w-corbello/Christmas_Light_Tester/board/Board_Connections.jpg

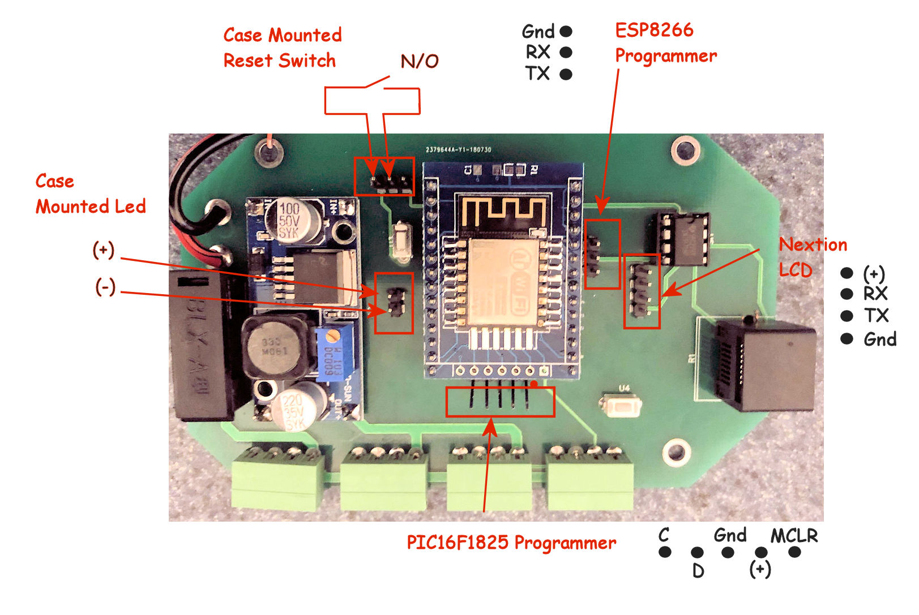
board/Board_Connections.jpg
