w-corbello/Christmas_Light_Tester/board/IMG_1061.JPG

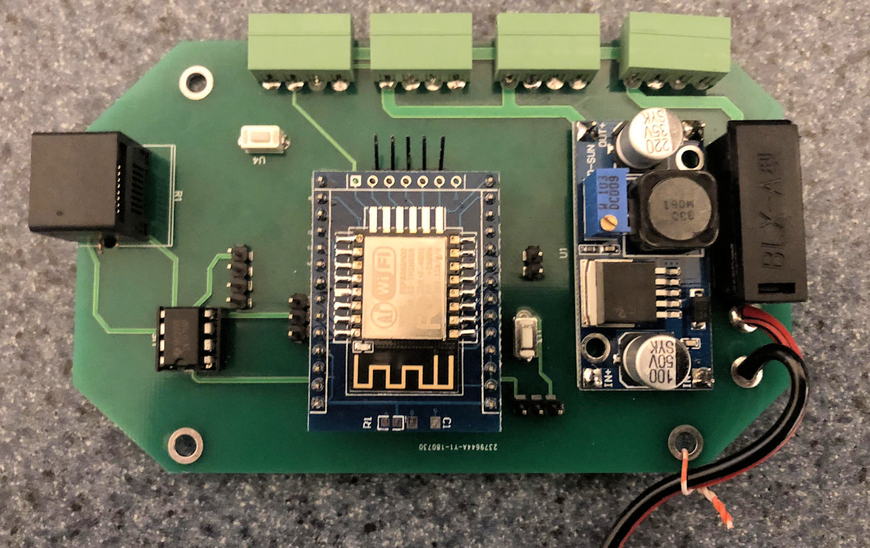
board/IMG_1061.JPG
