w-corbello/Christmas_Light_Tester/schematics/README.md

Files:

Board_Connections.jpg - shows where to make connection

Christmas Light Tester.pdf - manual

PC_Bottom_Board.pdf - PC board bottom

PC_Complete_Board.pdf -  PC board complete

PC_Top_Board.pdf - PC board top

Schematic_tester.pdf - electrical

Components.txt - components used
