w-corbello/Christmas_Light_Tester/board/README.md

Pictures of boards:

EasyEDA.com was used to draw the board, they also offer manufacturing of the boards. "EasyEDA_ Xmas_light_tester_v3.svg" can be imported from the EasyEDA.com website to view or modify the boards.
