w-corbello/Christmas_Light_Tester/files/README.md

Artnet_Sender.h  -  Transmits DMX over wifi usinf artnet or sacn.

Christmas_Tester_06122018_v3_7.ino - Main Aduino program.

EEPROM_Map.txt - used just to keep track of eeprom locations I'm using.

monitor.h - Used to monitor or view a sacn being transmitted.

nextion_1.h - Used to 'talk' to the Nextion LCD module over serial.

remote_1.h - Function file I wanted out of the main Arduino program.

renard.h - Used to transmit the Renard protocol.

ws2801.h - Used to test the 4 wire WS2801.
