w-corbello/Christmas_Light_Tester/nextion/README.md

Nextion is an intelligent LCD display which incorporates a LCD touch screen with a mcu. You program the LCD using dedicated software. Using the software you draw text boxes, buttons etc. The itmes you draw can then be used to communicate with an external mcu over serial communication.

https://nextion.itead.cc/
