w-corbello/Christmas_Light_Tester/board/IMG_1062.JPG

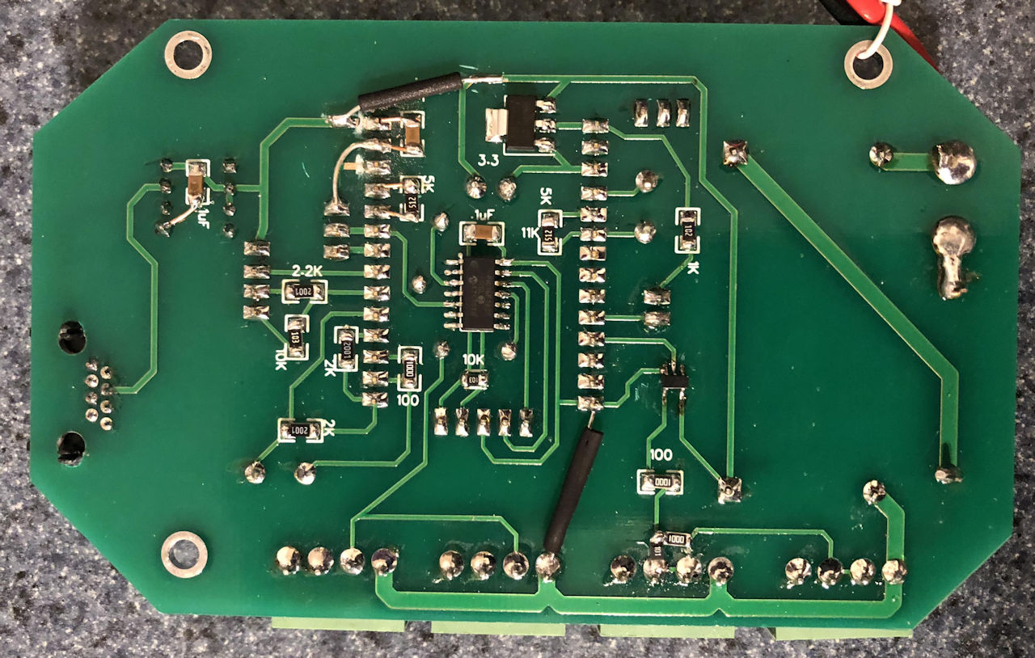
board/IMG_1062.JPG
