w-corbello/Christmas_Light_Tester/schematics/Christmas Light Tester.pdf

Main Menu

Select one of the modes
you wish to test.

Or select the Gear Icon for settings


Test E1.31

Calib - emits one Red LED, two Green LEDs and three
Blue LEDS. Used to verify
order. If your LED show up with a different color, you can then program controller or sequencing software to
fix.

Connect - Connect to WiFi

Disconnect - Disconnect
from WiFi

# Christmas Light Tester


Run 3 Wire

Calibrate - emits one Red
LED, two Green LEDs and
three Blue LEDS. Used to
verify order. If your LED
show up with a different
color, you can then
program controller or
sequencing software to fix.


Run WS2801

Calibrate - emits one Red
LED, two Green LEDs and
three Blue LEDS. Used to
verify order. If your LED
show up with a different
color, you can then
program controller or
sequencing software to fix.

# Christmas Light Tester


Setup Functions

Select which function you want to change parameters.


Run Renard

Run Man - Illuminates Channel listed from off to full on, over and over.

Run Auto - - Starts at channel 1 and runs through Max Channel.

Dim All - Illuminates all channels to Max Channel.

Arrow Up/Down - manually
increase/decrease current
channel in Run Man.

Channel - click here to manually change working channel

# Christmas Light Tester


Setup 3 Wire

Type number first then press selected button you want to save to.

Size - Number of nodes

Bright - How bright the leds will light up.

ESC - leave the screen


Setup E1.31

Type number first then press selected button you want to save to.

IP - Change E1.31 IP address

Port - Change UDP port

Univ - DMX universe number

Size - Number of nodes

Bright - How bright the leds will light up.

ESC - leave the screen

# Christmas Light Tester


Setup Renard

Type number first then press selected button you want to save to.

Baud - 0=57600; 1=115200, 2=230400 & 3=460800

Man - smoothness of illumination (man mode)

Auto - smoothness of illumination (auto mode)

Size - Number of nodes

Delay - How fast we cycle through channels

ESC - leave the screen

Setup WS2801

Type number first then press selected button you want to save to.

Size - Number of nodes

Bright - How bright the leds will light up.

ESC - leave the screen

# Christmas Light Tester


View Screen

Views settings for all setup parameters.


Front of controller

LED light up when connected to WIFI.

# Christmas Light Tester

# Christmas Light Tester

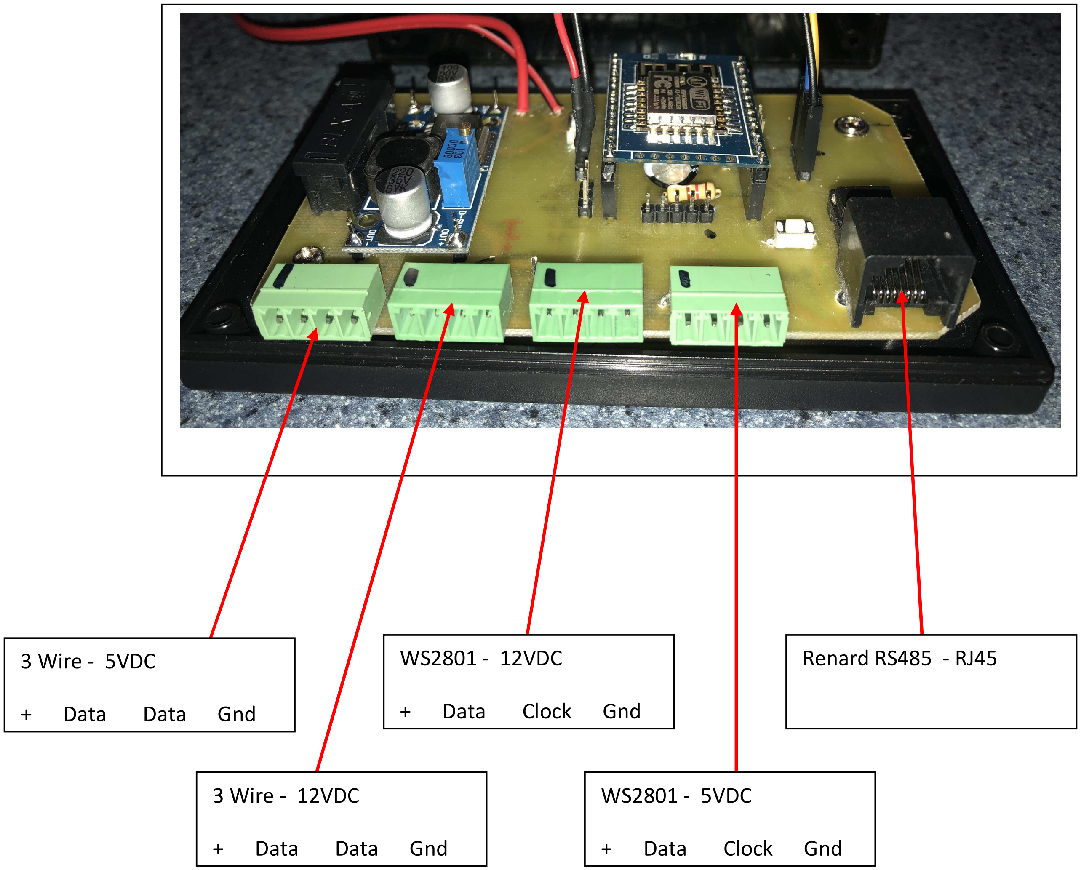
[picture p25: figure]
3 Wire - 5VDC; Data; Gnd; 3 Wire - 12VDC; WS2801 - 12VDC; Clock; WS2801 - 5VDC; Renard RS485 - RJ45


Pic16F1825 - ICSP

PGD | PGC | GND VDD | MCLR

ESP8266 IO0

Used for programming. Hold down while pressing Reset button. Release Reset button then release PGM button

ESP8266 Reset

Used for programming

# Christmas Light Tester

# Christmas Light Tester

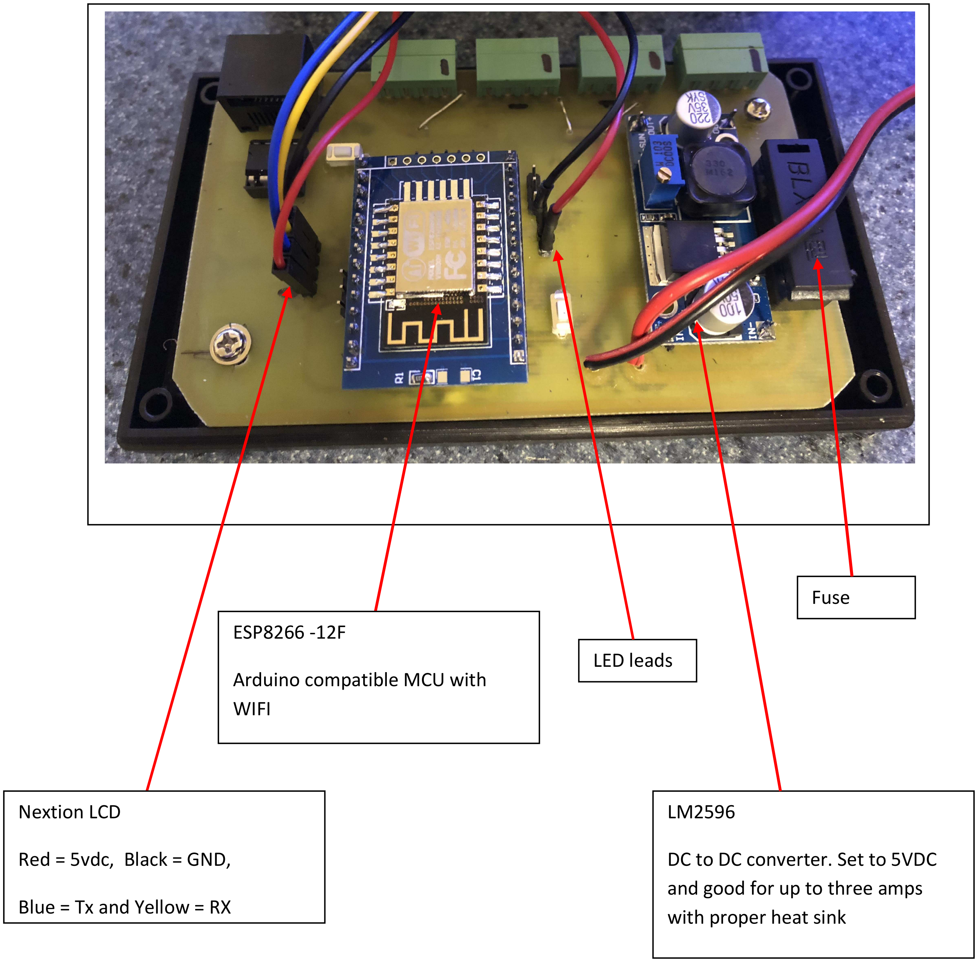
[picture p26: figure]
Nextion LCD; Red = 5vdc, Black = GND,; Blue = Tx and Yellow = RX; ESP8266 -12F; Arduino compatible MCU with; WIFI; DC to DC converter. Set to 5VDC; and good for up to three amps; with proper heat sink; Fuse; LED leads


Testing a 12vdc, WS2801 4
wire pixel

# Christmas Light Tester
