w-corbello/Christmas_Light_Tester/schematics/PC_Bottom_Board.pdf

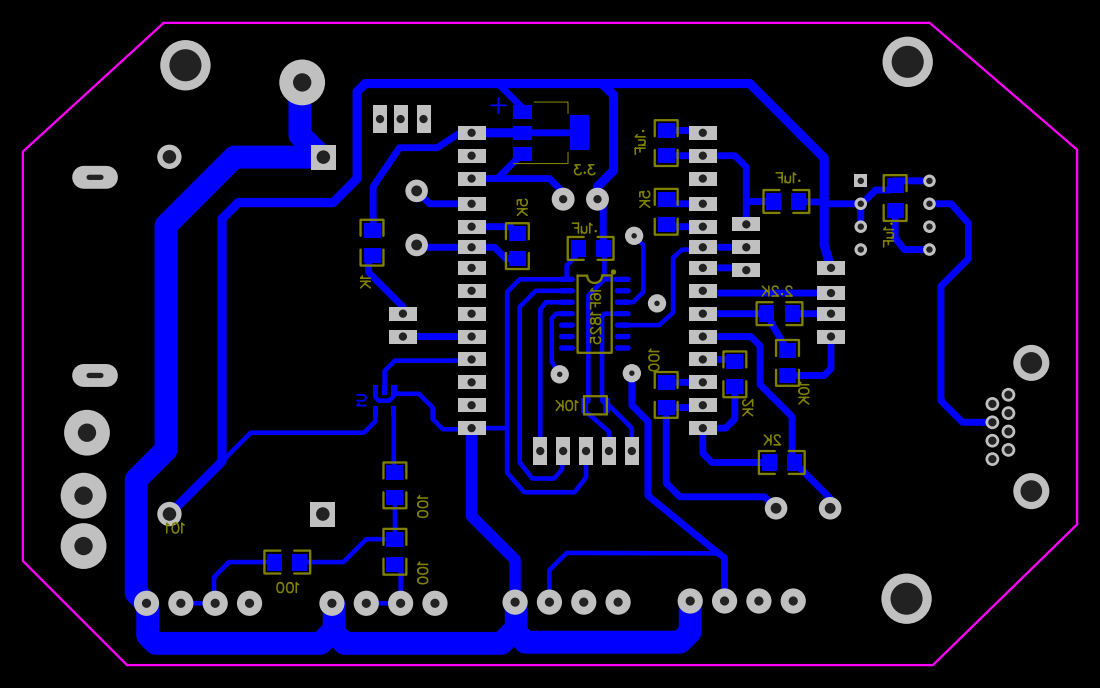
[picture p27: page 1]
