w-corbello/Christmas_Light_Tester/schematics/PC_Complete_Board.pdf

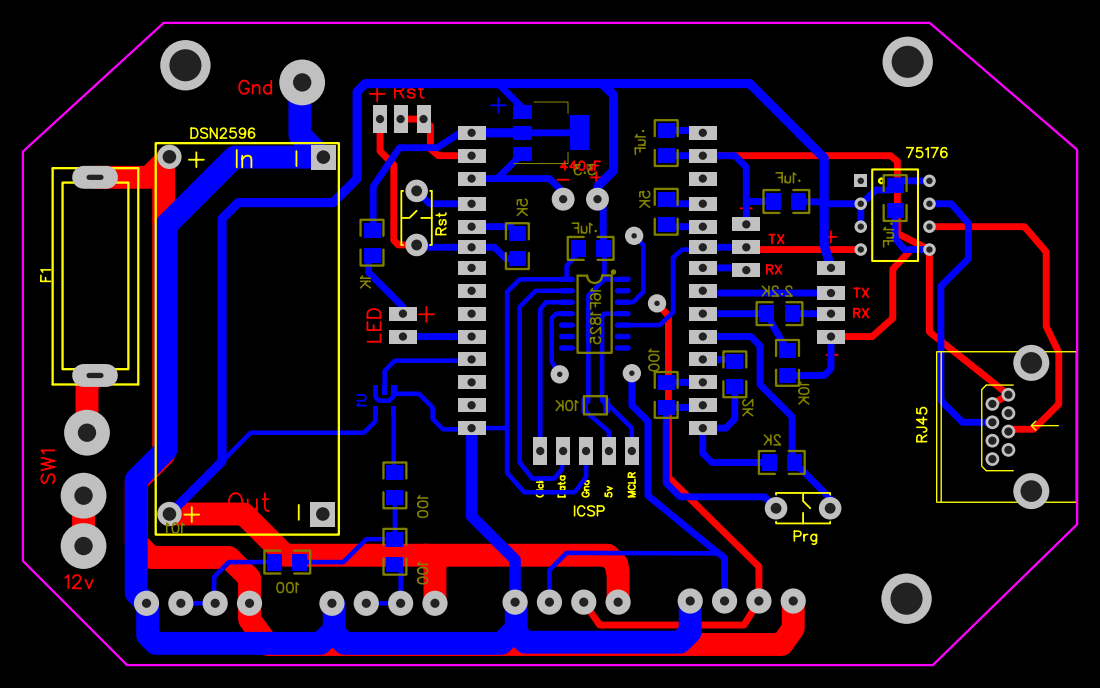
[picture p28: page 1]
