w-corbello/Christmas_Light_Tester/schematics/PC_Top_Board.pdf

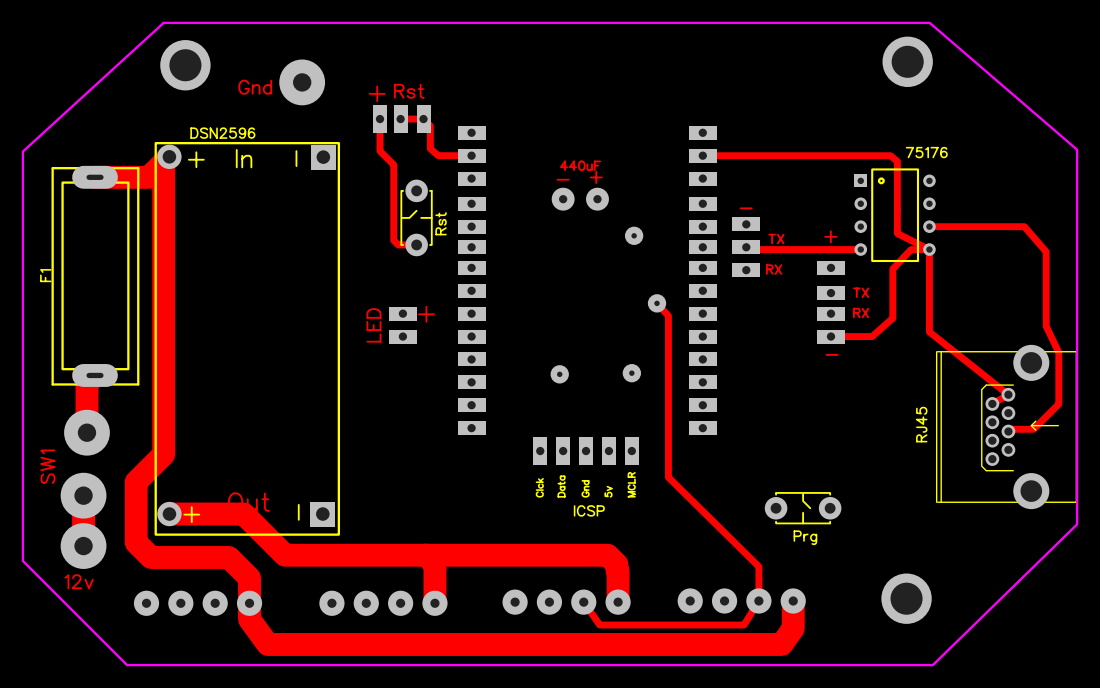
[picture p29: page 1]
