w-corbello/Christmas_Light_Tester/schematics/Schematic_tester.pdf

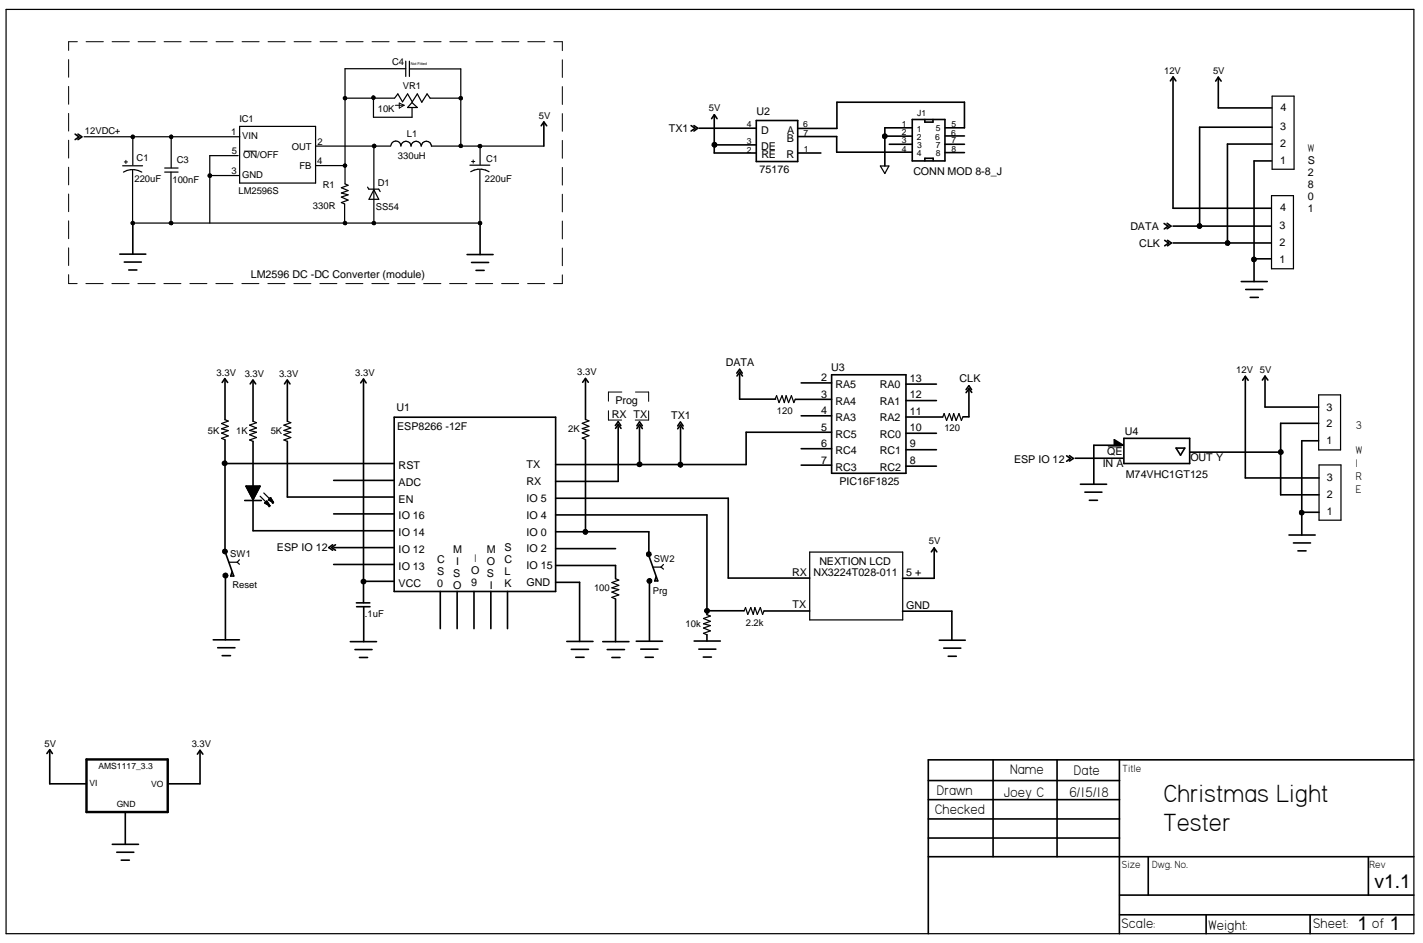
[picture p30: page 1]

LM2596 DC -DC Converter (module)

Drawn | Joey C | 6/15/18
Checked
