w-corbello/Christmas_Light_Tester/(commit log)

2018-08-24 Create boards
2018-09-04 Add files via upload
    Shows external connections to board.
